jawamustang/079721-2351/datasheets/MX5_ECU_Pinouts.jpg

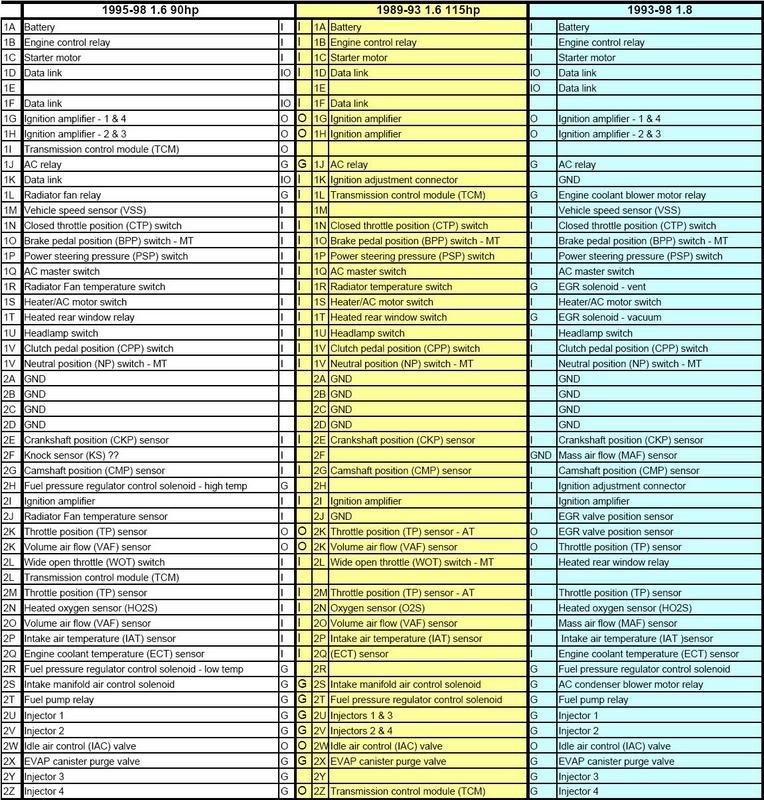
datasheets/MX5_ECU_Pinouts.jpg
