jawamustang/079721-2351/README.md

# 079721-2351
Mazda Mx-5 Na 1990 board
 Mazda MX-5 Miata Ecu reverse engineered
 
 Ecu version B63H
 079700-2633
 18 881c
 
 PCB version 079721-2351
