jawamustang/079721-2351/EcuVersions.txt

B61P-18-881A			079700-2383
B61P-18-881B			079700-2385
B61P-18-881R			9707979-238			Board: 079721-2351

B63H-18-881B			079700-2632			Board: 079721-2351
B63H-18 881C			079700-2633			Board: 079721-2351

B64J-18-881				079700-3041
B64F-18-881				079700-3030
B64F-18-881				079700-3031
B64F-18-881A			079700-3032

B64E-18-881				079700-3031
B64E-18-881A			079700-3032

B66B-18-881B			079700-3051			Board: 079721-2351
