jawamustang/079721-2351/datasheets/connector_mx-5NA90-93.png

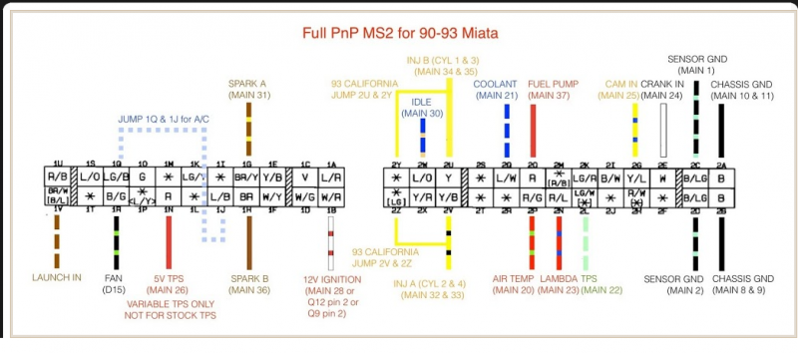
datasheets/connector_mx-5NA90-93.png
