jawamustang/079721-2351/KiCadProject/079721-2351/079721-2351.kicad_pcb

## KiCad design KiCadProject/079721-2351/079721-2351.kicad_pcb (2020-06-08)

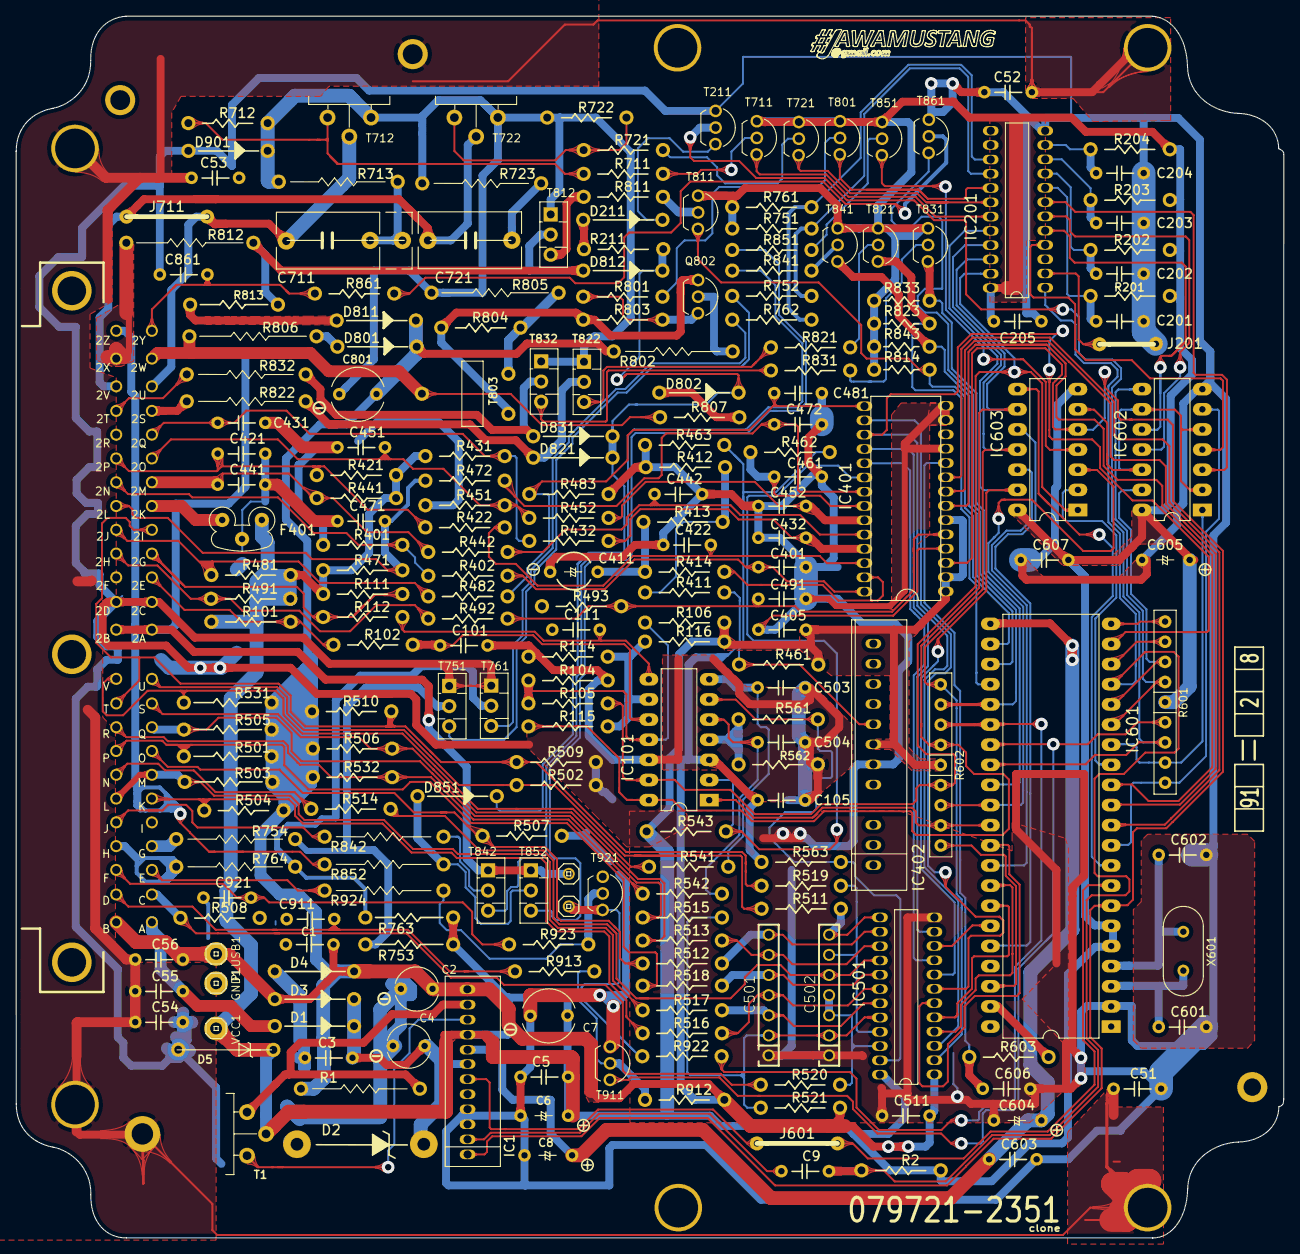
[picture p3: board 079721-2351.kicad_pcb from above]

Board: 2 copper layers, 159.9 x 154.1 mm, 241 parts (0 on the bottom side), 180 nets.

Parts:
C1, C3, C105, C421, C431, C451, C471, C503, C504, C511, C911, C921: 47nf; C_6mm
C2, C4: 33uf35Velec; C_electrolytic_6mm_P4mm
C5, C9, C52, C53, C54, C55, C56, C401, C405, C422, C432, C442, C461, C472, C481, C491, C603, C607: 10nF (103); C_6mm
C6, C8, C604, C605: 3.3uF 16V; C_tantalum_6mm
C7: 220uf10Velec; C_electrolytic_7mm_P5mm
C51, C441, C861: empty; C_6mm
C101, C204: 1nF (102) 100V; C_6mm
C111: 10nF50V; C_6mm
C201, C202, C203: 3,3nF (332) 100V; C_6mm
C205, C452: 100nf; C_6mm
C411: 3.3uf50Velec; capacitorPolarisedMazda6mm
C501, C502: C_Array_7; C_array_6
C601, C602, C606: 20 pF (20); C_6mm
C711: 680fF 100V; C_rect_17mm_7m_3_pin
C721: 680fF 100V; C_rect_13mm_7m_2_pin
C801: 47uf35Velec; C_electrolytic_7mm_P5mm
D1, D3, D4, D801, D802, D811, D812, D901: 1E1; D
D2: about 27v 5W; D_zener_big
D5: 6.2B1; D_zener_small
D211: Not sure propably zener; D
D821, D831, D851: empty; D
F401: 223s; EMI_filter_LCL
GND1: Conn_01x01_Female; pinhead-1-1X01
H1: MountingHole; MountingHole_2.7mm_M2.5_ISO7380_Pad
H2, H3, H4: MountingHole_Pad; MountingHole_5mm
H6, H10: MountingHole; MountingHole_2.2mm_M2_ISO14580_Pad
H7: MountingHole_Pad; MountingHole_2.2mm_M2_ISO14580_Pad
H8, H9, H11: MountingHole; MountingHole_5mm
IC1: HC244
IC101: uPC177C; DIP-14_W7.62mm_LongPads
IC201: MP493; DIL24S
IC401: D151811-0360; DIL28S
IC402: IS157
IC501: D151821-0020; DIL24S
IC601: MP5273
IC602: 4071; DIP-14_W7.62mm_LongPads
IC603: 4069; DIP-14_W7.62mm_LongPads
J44: Conn_02x11_0x13_Top_Bottom_Shielded-MazdaProjekt_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; Connector_13x02_11x02_174917-6
J201: Connected; J_short
J601: Connected; J
J711: Empty; J
PLUSB1: Conn_01x01_Female; pinhead-1-1X01
Q802: C945; TO-92
R1, R822, R832, R852, R924: empty; R_15mm
R2, R102, R112, R211, R402, R422, R441, R442, R462, R463, R472, R481, R482, R511, R512, R513, R514, R515, R516, R517, R518, R519, R520, R541, R542, R561: 10k; R_10mm
R101, R712: 1K; R_10mm
R104, R114, R521: 22k; R_10mm
R105, R115: 13k; R_10mm
R106, R116, R563: 18k; R_10mm
R111, R414, R722: 1k; R_10mm
R201, R203: 68K 2%; R_10mm
R202: 100K 2%; R_10mm
R204: 36K 2%; R_10mm
R401: 1.5M; R_10mm
R411, R412: 1k 2%; R_10mm
R413: 36K; R_10mm
R421, R431: 2,7K2%; R_10mm
R432, R452, R493: 10K; R_10mm
R451, R461, R483, R491, R492, R509, R821, R831, R851, R861: empty; R_10mm
R471, R543, R803, R807, R912: 4.7k; R_10mm
R501, R503, R505, R531: 680R; R_12mm
R502, R504, R506, R507, R508, R510, R532, R751, R761, R801, R804: 2.2k; R_10mm
R562: 30K; R_10mm
R601: R_Network08_US_mazda; R_arrray_8
R602: R; R_arrray_8
R603, R711, R721, R752, R762, R811, R841, R922: 300R; R_10mm
R713, R723: 47R 1W; R_15mm
R753, R763, R813: 63R; R_12mm
R754, R764: 2.2R (m 2.8R) 1W; R_15mm
R802: 361R 1W; R_15mm
R805, R806: 8.2R2W; R_17mm
R812: 3.9R2W; R_17mm
R814, R843: empty; R_7mm
R823, R833: 4.7K; R_7mm
R842: 3.9R (m 4.8R) 1W; R_15mm
R913, R923: 330R; R_10mm
T1: 2SB1015B
T211, T911, T921: RN1006; TO-92
T711, T721, T801, T841: 2CS2001; TO-92
T712, T722: 2SD1415
T751, T761, T812, T842: CE1A3Q; TO-126-3_Vertical
T803: 2CS4065; 2SC4065
T811: 2SC1815; TO-92
T821, T831, T851, T861: Empty; TO-92
T822, T832, T852: CE1A3Q (empty); TO-126-3_Vertical
T921A1, T921B1: Conn_01x01_Female; pinhead-1-1X01
VCC1: Conn_01x01_Female; pinhead-1-1X01
X601: Crystal; Crystal_HC18-U_Vertical

Connections:
2S: J44.2S, R822.2
2T: J44.2T, R832.2
2Y: C861.1, J44.2Y, R861.2
+5V: C5.1, C6.1, C7.1, C205.2, C405.1, C605.1, C607.1, D5.1, F401.3, IC1.4, IC201.24, IC401.1, IC401.2, IC401.6, IC402.6, IC501.24, IC601.4, IC601.5, IC602.14, IC603.14, R2.1, R101.2, R106.1, R111.2, R116.1, R201.1, R202.1, R203.1, R204.1, R421.1, R431.2, R441.1, R461.1, R471.2, R481.1, R491.1, R543.2, R601.5, R602.5, R751.2, R753.1, R761.2, R763.1, R814.2, R823.2, R833.2, R843.2, T1.1, T711.1, T721.1, T801.1, T811.1, T821.1, T831.1, T841.1, T851.1, VCC1.1
+12V: C1.1, C2.1, C56.1, C105.2, C511.1, C801.1, D3.2, D4.1, D801.1, D811.1, IC1.1, IC101.3, IC501.1, J44.B, PLUSB1.1, R1.2, R411.1, R501.1, R503.1, R504.1, R505.1, R506.2, R510.2, R521.1, R531.1, R532.2, R563.2, R802.2, R912.1
+BATT: C55.1, D1.2, J44.A
/IC201_8: C201.2, IC201.8, R201.2
/IC201_9: C202.2, IC201.9, R202.2
/IC201_10: C203.2, IC201.10, R203.2
/IC201_11: C204.2, IC201.11, R204.2
/IC201_15: IC201.15, R761.1, R762.1
/IC201_16: IC201.16, R751.1, R752.1
/IC201_17: IC201.17, T801.3
/IC201_18: IC201.18, T721.3
/IC201_19: IC201.19, T711.3
/IC401_5: C491.2, IC401.5, R492.1, R493.1
/IC401_15: C481.2, IC401.15, R482.1, R483.2
/IC401_20: IC101.2, IC401.20, R543.1
/IC401_21: C472.2, IC401.21, R472.1
/IC401_22: C461.2, IC401.22, R462.2
/IC401_23: C452.1, IC401.23, R452.1
/IC401_24: C442.2, IC401.24, R442.1
/IC401_25: C432.1, IC401.25, R432.1
/IC401_26: C422.1, IC401.26, R422.1
/IC401_27: IC401.27, R414.1
/IC401_28: C401.2, IC401.28, R402.1
/IC501_13: C502.7, IC501.13, R511.1
/IC501_14: C501.7, IC501.14, R512.1
/IC501_15: C501.6, IC501.15, R513.1
/IC501_16: C502.5, IC501.16, R514.1
/IC501_17: C501.5, IC501.17, R518.1
/IC501_18: C501.4, IC501.18, R516.1
/IC501_19: C501.3, IC501.19, R517.1
/IC501_20: C501.2, C502.2, IC501.20, R515.1, R521.2
/IC501_21: C502.6, IC501.21, R519.1
/IC501_22: C502.3, C502.4, IC501.22, R520.1
/IC601_7: IC601.7, J601.2
/IC601_8: IC601.8, IC603.8
/IC601_13: IC601.13, IC603.2
/IC601_21: C8.1, C603.2, C604.1, IC1.5, IC601.21
/IC601_22: IC601.22, R814.1, T811.3
/IC601_23: IC601.23, R843.1, T841.3
/IC601_24: IC601.24, R823.1, T821.3
/IC601_29: IC601.29, R833.1, T831.3
/IC601_33: IC601.33, IC603.12
/IC601_37: IC601.37, IC603.10
/IC601_40: IC601.40, R603.1
AC_relay: J44.J, R842.2
AC_switch: J44.Q, R505.2, R515.2
Airflow_meter_5V: F401.1, J44.2K
Airflow_meter_intake_air_thermosensor: C421.2, J44.2P, R421.2, R422.2
Blower_motor_switch: J44.S, R506.1, R513.2
California_emission: J44.2H, R491.2, R492.2
Check_engine_indicator: J44.E, R924.2
Crank_angle_sensor_G_CMP: J44.2G, R111.1, R112.2
Crank_angle_sensor_N_CPK: J44.2E, R101.1, R102.2
D851: D802.1, D812.1, D821.1, D831.1, D851.1, R211.1
EVAP_canister_purage_valve: J44.2X, R812.2
GND: C801.2, D901.1, J44.2A, J44.2B, R712.1, R713.2, R722.2, R723.2, R805.2, T712.3, T722.3, T812.1, T822.1, T832.1, T842.1, T852.1, T921A1.1
GNDA: C51.2, C52.1, C53.2, C54.2, C55.2, C56.2, H1.1, H2.1, H3.1, H4.1, H7.1, H11.1
GNDS: C1.2, C2.2, C3.2, C4.2, C5.2, C6.2, C7.2, C8.2, C51.1, C52.2, C53.1, C54.1, C101.1, C105.1, C111.2, C201.1, C202.1, C203.1, C204.1, C205.1, C401.1, C405.2, C411.2, C421.1, C422.2, C431.1, C432.2, C441.1, C442.1, C451.2, C452.2, C461.1, C471.2, C472.1, C481.1, C491.1, C501.1, C502.1, C503.1, C504.1, C511.2, C601.1, C602.1, C603.1, C604.2, C605.2, C606.1, C607.2, C861.2, C911.2, C921.2, D2.2, D4.2, D5.2, D901.2, F401.2, GND1.1, IC1.9, IC1.10, IC101.12, IC201.12, IC401.4, IC401.11, IC401.13, IC401.14, IC402.5, IC501.12, IC601.1, IC602.7, IC603.7, J44.2C, J44.2D, J201.2, R104.1, R114.2, R401.2, R412.2, R451.2, R463.2, R483.1, R493.2, R502.1, R507.1, R508.1, R509.1, R562.1, T211.1, T751.1, T761.1, T861.1, T911.1, T921.1
Headlight_switch: J44.U, R502.2, R511.2
IC201_4: IC201.4, IC602.4
IC201_5: IC201.5, IC602.10
IC201_6: IC201.6, IC602.11
IC201_7: IC201.7, IC602.3
IC201_20: IC201.20, IC501.8, IC603.13
IC201_21: IC201.21, IC501.2, IC603.11, R602.9
IC201_22: IC101.14, IC201.22, IC603.9, R115.2, R602.6
IC201_23: IC101.13, IC201.23, IC603.1, R105.1, R602.4
IC401_10: C606.2, IC401.10, R603.2
IC401_16: IC401.16, IC501.7
IC401_18: IC401.18, IC501.11
IC401_19: IC401.19, IC501.9
IC601_6: IC1.12, IC401.3, IC601.6, IC603.5
IC601_9: IC601.9, IC602.6, R601.1
IC601_10: IC401.9, IC601.10
IC601_11: IC401.8, IC601.11
IC601_12: IC401.7, IC601.12
IC601_14: IC601.14, IC602.1, R601.2
IC601_15: IC601.15, IC602.8, R601.6
IC601_16: IC601.16, IC602.13, R601.7
IC601_17: C9.1, IC201.1, IC601.17, R2.2
IC601_18: IC601.18, R601.8
IC601_19: IC401.17, IC501.3, IC601.19
IC601_20: IC601.20, R601.9
IC601_25: IC601.25, R602.8, T861.3
IC601_26: IC601.26, R602.7, R922.1
IC601_27: IC601.27, R601.4, T911.3
IC601_28: IC601.28, R601.3, T211.2
IC601_30: IC601.30, IC603.3, R602.3
IC601_31: IC101.1, IC601.31, R602.2
IC601_32: IC501.6, IC601.32
IC601_34: IC501.4, IC601.34
IC601_35: IC501.5, IC601.35
IC601_36: IC501.10, IC601.36
IC601_39: IC601.39, R602.1
Idle_air_control_valve: J44.2W, R806.2, R807.2, T803.2
Igniter_E: J44.2I, J44.T, R509.2, R510.1, R519.2
Ignition_amp_1&4: J44.G, R754.2
Ignition_amp_2&3: J44.H, R764.2
Injectors_1_3: C711.1, J44.2U, J711.2, T712.2
Injectors_2_4: C721.2, J44.2V, J711.1, T722.2
K: J44.K, R504.2, R516.2
unnamed: C3.1, C4.1, D1.1, D2.1, D3.1, IC1.6
unnamed: C9.2, IC1.11
unnamed: C101.2, IC101.10, R102.1
unnamed: C111.1, IC101.8, R112.1
unnamed: C411.1, R413.2, R414.2
unnamed: C503.2, IC101.7, R541.1
unnamed: C504.2, IC101.5, R542.1
unnamed: C601.2, IC601.2, X601.2
unnamed: C602.2, IC601.3, X601.1
unnamed: C711.2, R713.1
unnamed: C721.1, R723.1
unnamed: D211.1, T211.3
unnamed: D211.2, R211.2
unnamed: D801.2, R806.1
unnamed: D802.2, R807.1
unnamed: D811.2, R813.2
unnamed: D812.2, R812.1, R813.1, T812.2
unnamed: D821.2, R822.1, T822.2
unnamed: D831.2, R832.1, T832.2
unnamed: D851.2, R852.1, T852.2
unnamed: IC1.2, R1.1, T1.3
unnamed: IC1.3, T1.2
unnamed: IC1.7, J601.1
unnamed: IC101.4, R561.2, R562.2
unnamed: IC101.9, R114.1, R115.1, R116.2
unnamed: IC101.11, R104.2, R105.2, R106.2
unnamed: IC201.2, J201.1
unnamed: IC402.7, R461.2, R462.1, R463.1
unnamed: IC602.2, IC602.5, IC602.9, IC602.12, IC603.6
unnamed: IC603.4, T851.3
unnamed: Q802.1, R803.2, R804.2, T803.3
unnamed: Q802.2, R802.1
unnamed: Q802.3, R801.2, R803.1
unnamed: R411.2, R412.1, R413.1
unnamed: R711.1, T711.2
unnamed: R711.2, R712.2, T712.1
unnamed: R721.1, T721.2
unnamed: R721.2, R722.1, T722.1
unnamed: R752.2, T751.3
unnamed: R753.2, R754.1, T751.2
unnamed: R762.2, T761.3
unnamed: R763.2, R764.1, T761.2
unnamed: R801.1, T801.2
unnamed: R804.1, R805.1, T803.1
unnamed: R811.1, T811.2
unnamed: R811.2, T812.3
unnamed: R821.1, T821.2
unnamed: R821.2, T822.3
unnamed: R831.1, T831.2
unnamed: R831.2, T832.3
unnamed: R841.1, T841.2
unnamed: R841.2, T842.3
unnamed: R842.1, T842.2
unnamed: R851.1, T851.2
unnamed: R851.2, T852.3
unnamed: R861.1, T861.2
unnamed: R912.2, R913.1, T911.2
unnamed: R922.2, T921.3, T921B1.1
unnamed: R923.1, R924.1, T921.2
Neutral_or_clutch_switch: J44.V, R531.2, R541.2
Oxygen_sensor: J44.2N, R401.1, R402.2
Power_steering_pressure_switch: J44.P, R501.2, R518.2
Radiator_fun_temperature_sensor: J44.2J, R481.2, R482.2
Radiator_temperature_switch: J44.R, R532.1, R542.2
Self_diagnostic_checker_code_no: C921.1, J44.F, R923.2
Self_diagnostic_checker_monitor_lamp: C911.1, J44.D, R913.2
Starter_motor: J44.C, R508.2, R520.2
Stoplight_switch: J44.O, R507.2, R512.2
Throttle_position_sensor: C441.2, J44.2M, R441.2, R442.2
Throttle_sensor_idle_terminal: J44.N, R514.2
Throttle_wide_open_sensor: C471.1, J44.2L, R471.1, R472.2
Transsmision_control_module: J44.2Z, R852.2
Transsmision_control_module_2: J44.L, J44.M, R503.2, R517.2
Volume_airflow_sensor: C451.1, J44.2O, R451.1, R452.2
Vref: IC101.6, IC501.23, R561.1, R563.1
Water_thermosensor: C431.2, J44.2Q, R431.1, R432.2
