jawamustang/079721-2351/(commit log)

2019-10-27 Mazda Mx-5 Ecu board
    [079721-2351.kicad_pcb, 079721-2351.sch]
2019-11-01 almost all elements
    [079721-2351.kicad_pcb]
2019-11-01 caps and res
    [079721-2351.kicad_pcb]
2019-11-02 all elements
    [079721-2351.kicad_pcb]
2019-12-25 Bottom: wires -> labels
2020-01-05 complete 0.1
    [079721-2351.kicad_pcb]
2020-01-05 Version 0.99
    [079721-2351.kicad_pcb, board.dxf]
2020-01-06 Bug fix 1
    [079721-2351.kicad_pcb]
2020-01-27 Pinhead to vias conversion
    [079721-2351.kicad_pcb]
2020-02-09 Paths elements
    [079721-2351.kicad_pcb]
2020-02-09 gnd filed zones
    [079721-2351.kicad_pcb]
2020-02-13 Board layers fix
2020-03-01 GND mess cleanup
2020-03-01 12V line mess cleanup
    [079721-2351.kicad_pcb]
2020-03-01 Cleanup, this commit brings great chaos
    [079721-2351.kicad_pcb]
2020-03-02 Schematic reordering
    [079721-2351.kicad_pcb]
2020-03-02 Schematic reconfiguration
    [079721-2351.kicad_pcb]
2020-03-06 Input description TODO: Correct transistors pins
    [079721-2351.kicad_pcb]
2020-03-08 Schematic is Ok Libraries are messy (It needs to be fixed) Pcb shape needs to be checked Holes position are not precisely
    [079721-2351.kicad_pcb]
2020-03-09 Schematic library cleanup
    [079721-2351.kicad_pcb]
2020-03-09 some cleanup
    [079721-2351.kicad_pcb]
2020-03-12 New footprint lib
    [079721-2351.kicad_pcb]
2020-03-12 Footprints moved to local lib
    [079721-2351.kicad_pcb]
2020-03-12 lib cleanup
    [079721-2351.kicad_pcb]
2020-03-13 Schematic cleanup
2020-03-14 3D Models update
    [079721-2351.kicad_pcb]
2020-03-15 Board shape
    [079721-2351.kicad_pcb, board.dxf]
2020-03-18 Board cleanup
    [079721-2351.kicad_pcb]
2020-03-18 Lib fix
    [079721-2351.kicad_pcb]
2020-03-18 2h Pin update
    [079721-2351.kicad_pcb]
2020-03-19 ic601 pinout fix
    [079721-2351.kicad_pcb]
2020-03-19 IC401 pinout fix
    [079721-2351.kicad_pcb]
2020-03-28 Holes locations
    [079721-2351.kicad_pcb]
2020-04-05 Holes edition, masks edition
    [079721-2351.kicad_pcb]
2020-04-07 Board desciption, and logo
    [079721-2351.kicad_pcb]
2020-04-08 Holes correction
    [079721-2351.kicad_pcb]
2020-05-17 C-array is not easy to buy, so I moved pins to fit in their place dip14 socket, so you can do your own c-array. I still need to move transistor T712, T722, T1, to perfectly fit radiators. Board holes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
    [079721-2351.kicad_pcb]
2020-05-30 parts footprings update, holes positions update
    [079721-2351.kicad_pcb]
2020-06-08 D151801 pins description update
    [079721-2351.kicad_pcb]
